dstamoulis/anonymous-dinosaurs/repoStorage/modelsim/README.txt

Modelsim - Modules to be simulated :

.encoder
.selector
.adders (partial logic)
.CPA

CAUTION : 
Maybe different folders should be made.
