dstamoulis/anonymous-dinosaurs/ProjectReport/ReportLaTeX/figures/1.png

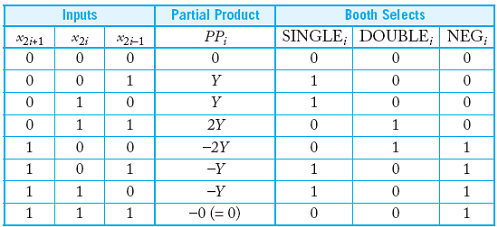
ProjectReport/ReportLaTeX/figures/1.png
