dstamoulis/anonymous-dinosaurs/(list of files, cad)

Other CAD files:
repoStorage/modelsim/adders/work/@c@p@a/verilog.psm
repoStorage/modelsim/adders/work/@f@afunct/verilog.psm
repoStorage/modelsim/adders/work/@f@t@c/verilog.psm
repoStorage/modelsim/adders/work/@f@t@cfunct/verilog.psm
repoStorage/modelsim/adders/work/@h@afunct/verilog.psm
repoStorage/modelsim/adders/work/@p@p@r/verilog.psm
repoStorage/modelsim/adders/work/funct@c@p@a/verilog.psm
repoStorage/modelsim/adders/work/funct@p@p@r/verilog.psm
repoStorage/modelsim/adders/work/muddlib07__a2o1_1x/verilog.psm
repoStorage/modelsim/adders/work/muddlib07__and2_1x/verilog.psm
repoStorage/modelsim/adders/work/muddlib07__fulladder/verilog.psm
repoStorage/modelsim/adders/work/muddlib07__inv_1x/verilog.psm
repoStorage/modelsim/adders/work/muddlib07__nand2_1x/verilog.psm
repoStorage/modelsim/adders/work/muddlib07__o22a2i_1x/verilog.psm
repoStorage/modelsim/adders/work/muddlib07__o2a1i_1x/verilog.psm
repoStorage/modelsim/adders/work/muddlib07__xnor_ds/verilog.psm
repoStorage/modelsim/adders/work/muddlib07__xor2_1x/verilog.psm
repoStorage/modelsim/adders/work/muddlib07__xor2_2x/verilog.psm
repoStorage/modelsim/adders/work/testbench/verilog.psm
repoStorage/modelsim/adders/work/testbench@c@h@e@c@k/verilog.psm
repoStorage/modelsim/adders/work/testbench@c@p@a/verilog.psm
repoStorage/modelsim/adders/work/testbench@c@p@afunct/verilog.psm
repoStorage/modelsim/adders/work/testbench@f@t@c/verilog.psm
repoStorage/modelsim/adders/work/testbench@f@t@cfunct/verilog.psm
repoStorage/modelsim/adders/work/testbench@p@p@r/verilog.psm
repoStorage/modelsim/adders/work/testbench@p@p@rfunct/verilog.psm
repoStorage/modelsim/adders/work/testbench@x@n@o@r/verilog.psm
repoStorage/modelsim/adders/work/wordlib8__@f@t@c/verilog.psm
repoStorage/modelsim/adders/work/wordlib8__@half@adder/verilog.psm
repoStorage/modelsim/adders/work/xnor_ds/verilog.psm
