dstamoulis/anonymous-dinosaurs/repoStorage/modelsim/adders/work/@f@t@c/_primary.vhd

library verilog;
use verilog.vl_types.all;
entity FTC is
    port(
        Cin             : in     vl_logic;
        I1              : in     vl_logic;
        I2              : in     vl_logic;
        I3              : in     vl_logic;
        I4              : in     vl_logic;
        C               : out    vl_logic;
        Cout            : out    vl_logic;
        S               : out    vl_logic
    );
end FTC;
