dstamoulis/anonymous-dinosaurs/repoStorage/modelsim/adders/work/@h@afunct/_primary.vhd

library verilog;
use verilog.vl_types.all;
entity HAfunct is
    port(
        a               : in     vl_logic;
        b               : in     vl_logic;
        sum             : out    vl_logic;
        carry           : out    vl_logic
    );
end HAfunct;
