dstamoulis/anonymous-dinosaurs/repoStorage/modelsim/adders/work/muddlib07__xnor_ds/_primary.vhd

library verilog;
use verilog.vl_types.all;
entity \muddlib07__xnor_ds\ is
    port(
        A               : in     vl_logic;
        B               : in     vl_logic;
        Y               : out    vl_logic
    );
end \muddlib07__xnor_ds\;
