dstamoulis/anonymous-dinosaurs/repoStorage/modelsim/adders/work/wordlib8__@half@adder/_primary.vhd

library verilog;
use verilog.vl_types.all;
entity \wordlib8__HalfAdder\ is
    port(
        a               : in     vl_logic;
        b               : in     vl_logic;
        Cout            : out    vl_logic;
        s               : out    vl_logic
    );
end \wordlib8__HalfAdder\;
