dstamoulis/anonymous-dinosaurs/repoStorage/modelsim/adders/work/xnor_ds/_primary.vhd

library verilog;
use verilog.vl_types.all;
entity xnor_ds is
    port(
        A               : in     vl_logic;
        B               : in     vl_logic;
        Y               : out    vl_logic
    );
end xnor_ds;
